Redherring32/Xbox-Portable/README.md

# Xbox-Portable
Fully portable original (2001) Xbox handheld using real hardware

## License:

Licensed under
the TAPR Open Hardware License (www.tapr.org/OHL)

©Redherring32 2023-2024
