Redherring32/Xbox-Portable/PSU/BOM.csv

Query | Qty | Manufacturer | MPN | Octopart URL | Part Description | Description | Schematic Reference | Internal Part Number | Lifecycle | Lead Time | RoHS | Total Qty (@ Batch Size: 1) | SKU | SKU | SKU | SKU | SKU | Packaging | Packaging | Packaging | Packaging | Packaging | Unit Price (@ Batch Size: 1) | Unit Price (@ Batch Size: 1) | Unit Price (@ Batch Size: 1) | Unit Price (@ Batch Size: 1) | Unit Price (@ Batch Size: 1) | In Stock | In Stock | In Stock | In Stock | In Stock | MOQ | MOQ | MOQ | MOQ | MOQ | URL | URL | URL | URL | URL | Distributor [Lowest Price (Selected)] | SKU [Lowest Price (Selected)] | Packaging [Lowest Price (Selected)] | Unit Price (@ Batch Size: 1) [Lowest Price (Selected)] | Line Total [Lowest Price (Selected)] | Batch Total [Lowest Price (Selected)] | In Stock [Lowest Price (Selected)] | MOQ [Lowest Price (Selected)] | URL [Lowest Price (Selected)] | Notes
 |  |  |  |  |  |  |  |  |  |  |  |  | Digi-Key | Mouser | Newark | Onlinecomponents.com | RS Components | Digi-Key | Mouser | Newark | Onlinecomponents.com | RS Components | Digi-Key | Mouser | Newark | Onlinecomponents.com | RS Components | Digi-Key | Mouser | Newark | Onlinecomponents.com | RS Components | Digi-Key | Mouser | Newark | Onlinecomponents.com | RS Components | Digi-Key | Mouser | Newark | Onlinecomponents.com | RS Components
KGM05AR71C104JN | 5 | KYOCERA AVX | KGM05AR71C104JN | https://octopart.com/kgm05ar71c104jn-kyocera+avx-137404918 | Cap Cer 0.1UF 16V X7R 0402 | 0.1uF | C1, C24, C40, C56, C72 |  |  |  |  | 5
GRM32EC81A476KE19L | 15 | Murata | GRM32EC81A476KE19L | https://octopart.com/grm32ec81a476ke19l-murata-18041261 | Multilayer Ceramic Capacitor, 47 uF, 10 V, ± 10%, X6S, 1210 [3225 Metric] | 47uF | C2, C3, C4, C25, C26, C27, C41, C42, C43, C57, C58, C59, C73, C74, C75 |  | Production (Last Updated: 1 month ago) | 19w | Compliant | 15 | 490-8354-1-ND | 81-GRM32EC81A476KE9L | 43T5299 |  |  | Cut Tape | Tape & Reel | Cut Tape |  |  | 0.289 | 0.463 | 0.482 |  |  | 43324 | 3526 | 709 |  |  | 1 | 1 | 1 |  |  | https://octopart.com/opatz8j6/a1 | https://octopart.com/opatz8j6/a1 | https://octopart.com/opatz8j6/a1 |  |  | DigiKey | 490-8354-1-ND | Cut Tape | 0.289 | 4.335 | 4.335 | 43324 | 1 | https://octopart.com/opatz8j6/a1
CL10A226MO7JZNC | 28 | Samsung | CL10A226MO7JZNC | https://octopart.com/cl10a226mo7jznc-samsung-82337114 | Multilayer Ceramic Capacitor, 22 uF, 16 V, ± 20%, X5R, 0603 [1608 Metric] | 47uF | C5, C11, C12, C16, C28, C29, C30, C31, C44, C45, C46, C47, C60, C61, C62, C63, C76, C77, C78, C79, C8, C20, C36, C52, C68, C82, C83, C84 |  | Production (Last Updated: 4 years ago) | 22w | Non-Compliant | 28 | 1276-7076-1-ND | 187-CL10A226MO7JZNC |  |  |  | Cut Tape | Tape & Reel |  |  |  | 0.398 | 0.317 |  |  |  | 1140870 | 334159 |  |  |  | 1 | 1 |  |  |  | https://octopart.com/opatz8j6/a1 | https://octopart.com/opatz8j6/a1 |  |  |  | Mouser | 187-CL10A226MO7JZNC | Tape & Reel | 0.317 | 8.876 | 8.876 | 334159 | 1 | https://octopart.com/opatz8j6/a1
CL05A105KO5NNNC | 5 | Samsung | CL05A105KO5NNNC | https://octopart.com/cl05a105ko5nnnc-samsung-9301309 | Multilayer Ceramic Capacitor, 1 uF, 16 V, ± 10%, X5R, 0402 [1005 Metric] | 1uF | C6, C22, C38, C54, C70 |  | Production (Last Updated: 4 years ago) | 22w | Compliant | 5 | 1276-1067-1-ND | 187-CL05A105KO5NNNC | 82AC9181 |  |  | Cut Tape | Tape & Reel | Cut Tape |  |  | 0.1 | 0.1 | 0.104 |  |  | 3677274 | 281660 | 14503 |  |  | 1 | 1 | 1 |  |  | https://octopart.com/opatz8j6/a1 | https://octopart.com/opatz8j6/a1 | https://octopart.com/opatz8j6/a1 |  |  | DigiKey | 1276-1067-1-ND | Cut Tape | 0.1 | 0.5 | 0.5 | 3677274 | 1 | https://octopart.com/opatz8j6/a1
CL32A226KPJNNNE | 15 | Samsung | CL32A226KPJNNNE | https://octopart.com/cl32a226kpjnnne-samsung-20879308 | Cap Ceramic 22uF 10V X5R 10% SMD 1210 85°C Embossed T/R | 22uF | C9, C14, C15, C17, C18, C19, C33, C34, C35, C49, C50, C51, C65, C66, C67 |  | Production (Last Updated: 4 years ago) | 22w | Compliant | 15 | 1276-3372-1-ND | 187-CL32A226KPJNNNE |  |  |  | Cut Tape | Tape & Reel |  |  |  | 0.198 | 0.147 |  |  |  | 324463 | 119352 |  |  |  | 1 | 1 |  |  |  | https://octopart.com/opatz8j6/a1 | https://octopart.com/opatz8j6/a1 |  |  |  | Mouser | 187-CL32A226KPJNNNE | Tape & Reel | 0.147 | 2.205 | 2.205 | 119352 | 1 | https://octopart.com/opatz8j6/a1
CL10A475KP8NNNC | 6 | Samsung | CL10A475KP8NNNC | https://octopart.com/cl10a475kp8nnnc-samsung-9301844 | Multilayer Ceramic Capacitor, 4.7 uF, 10 V, ± 10%, X5R, 0603 [1608 Metric] | 4.7uF | C10, C23, C39, C55, C71, C88 |  | Production (Last Updated: 4 years ago) | 22w | Compliant | 6 | 1276-1044-1-ND | 187-CL10A475KP8NNNC | 82AC9299 |  |  | Cut Tape | Tape & Reel | Cut Tape |  |  | 0.1 | 0.1 | 0.104 |  |  | 7501831 | 1131283 | 5722 |  |  | 1 | 1 | 1 |  |  | https://octopart.com/opatz8j6/a1 | https://octopart.com/opatz8j6/a1 | https://octopart.com/opatz8j6/a1 |  |  | DigiKey | 1276-1044-1-ND | Cut Tape | 0.1 | 0.6000000000000001 | 0.6000000000000001 | 7501831 | 1 | https://octopart.com/opatz8j6/a1
CL10B104KB8NNNL | 5 | Samsung | CL10B104KB8NNNL | https://octopart.com/cl10b104kb8nnnl-samsung-21395620 | Multilayer Ceramic Capacitor, 0.1 uF, 50 V, ± 10%, X7R, 0603 [1608 Metric] | 0.1uF | C13, C32, C48, C64, C80 |  | Production (Last Updated: 4 years ago) | 22w | Compliant | 5 | 1276-CL10B104KB8NNNLCT-ND | 187-CL10B104KB8NNNL |  |  |  | Cut Tape | Tape & Reel |  |  |  | 0.1 | 0.1 |  |  |  | 2569681 | 390005 |  |  |  | 1 | 1 |  |  |  | https://octopart.com/opatz8j6/a1 | https://octopart.com/opatz8j6/a1 |  |  |  | DigiKey | 1276-CL10B104KB8NNNLCT-ND | Cut Tape | 0.1 | 0.5 | 0.5 | 2569681 | 1 | https://octopart.com/opatz8j6/a1
GRM188R61E106MA73J | 4 | Murata | GRM188R61E106MA73J | https://octopart.com/grm188r61e106ma73j-murata-46693355 | Multilayer Ceramic Capacitor, 10 uF, 25 V, ± 20%, X5R, 0603 [1608 Metric] | 10uF | C81, C86, C89, C90 |  | Production (Last Updated: 1 month ago) | 19w | Compliant | 4 | 490-12737-1-ND | 81-GRM188R61E106MA3J |  |  |  | Cut Tape | Tape & Reel |  |  |  | 0.29 | 0.28 |  |  |  | 93315 | 61644 |  |  |  | 1 | 1 |  |  |  | https://octopart.com/opatz8j6/a1 | https://octopart.com/opatz8j6/a1 |  |  |  | Mouser | 81-GRM188R61E106MA3J | Tape & Reel | 0.28 | 1.12 | 1.12 | 61644 | 1 | https://octopart.com/opatz8j6/a1
C1608X7R1E105K080AB | 1 | TDK | C1608X7R1E105K080AB | https://octopart.com/c1608x7r1e105k080ab-tdk-25947659 | Multilayer Ceramic Capacitor, 1 uF, 25 V, ± 10%, X7R, 0603 [1608 Metric] | 1uF | C85 |  | Production (Last Updated: 1 year ago) | 24w | Compliant | 1 | 445-5956-1-ND | 810-C1608X7R1E105K | 04X3256 |  |  | Cut Tape | Tape & Reel |  |  |  | 0.19 | 0.19 | 0.223 |  |  | 212176 | 5918 | 2 |  |  | 1 | 1 | 1 |  |  | https://octopart.com/opatz8j6/a1 | https://octopart.com/opatz8j6/a1 | https://octopart.com/opatz8j6/a1 |  |  | DigiKey | 445-5956-1-ND | Cut Tape | 0.19 | 0.19 | 0.19 | 212176 | 1 | https://octopart.com/opatz8j6/a1
CL10B473KO8NNNC | 1 | Samsung | CL10B473KO8NNNC | https://octopart.com/cl10b473ko8nnnc-samsung-9291615 | Cap Ceramic 0.047uF 16V X7R 10% SMD 0603 125°C Paper T/R | 47nF | C87 |  | Production (Last Updated: 4 years ago) | 22w | Compliant | 1 | 1276-2079-1-ND | 187-CL10B473KO8NNNC |  |  |  | Cut Tape | Tape & Reel |  |  |  | 0.1 | 0.1 |  |  |  | 1168873 | 7121 |  |  |  | 1 | 1 |  |  |  | https://octopart.com/opatz8j6/a1 | https://octopart.com/opatz8j6/a1 |  |  |  | DigiKey | 1276-2079-1-ND | Cut Tape | 0.1 | 0.1 | 0.1 | 1168873 | 1 | https://octopart.com/opatz8j6/a1
SIC437DED-T1-GE3 | 5 | Vishay | SIC437DED-T1-GE3 | https://octopart.com/sic437ded-t1-ge3-vishay-91387604 | 3-28V input, 12A microBUCK with Internal compensation, External Bias, 50 µA quie | SIC437BED-T1-GE3 | IC1, IC2, IC3, IC4, IC5 |  |  | 14w | Compliant | 5 | SIC437DED-T1-GE3CT-ND | 78-SIC437DED-T1-GE3 |  |  |  | Cut Tape | Tape & Reel |  |  |  | 1.93 | 1.93 |  |  |  | 7480 | 1737 |  |  |  | 1 | 1 |  |  |  | https://octopart.com/opatz8j6/a1 | https://octopart.com/opatz8j6/a1 |  |  |  | Mouser | 78-SIC437DED-T1-GE3 | Tape & Reel | 1.93 | 9.65 | 9.65 | 1737 | 1 | https://octopart.com/opatz8j6/a1
SRP7050TA-1R5M | 6 | Bourns | SRP7050TA-1R5M | https://octopart.com/srp7050ta-1r5m-bourns-64724107 | Inductor Power Shielded Wirewound 1.5uH 20% 100KHz 15Q-Factor Carbonyl Powder 12A 0.009Ohm DCR Automotive T/R | 1.5uH | L1, L2, L3, L4, L5, L6 |  |  | 20w | Compliant | 6 | SRP7050TA-1R5MCT-ND | 652-SRP7050TA-1R5M |  | SRP7050TA-1R5M |  | Cut Tape | Tape & Reel |  | Bulk |  | 1.32 | 1.12 |  |  |  | 1293 | 3054 |  | 1600 |  | 1 | 1 |  | 800 |  | https://octopart.com/opatz8j6/a1 | https://octopart.com/opatz8j6/a1 |  | https://octopart.com/opatz8j6/a1 |  | Mouser | 652-SRP7050TA-1R5M | Tape & Reel | 1.12 | 6.720000000000001 | 6.720000000000001 | 3054 | 1 | https://octopart.com/opatz8j6/a1
ERJ-2GEJ2R2X | 5 | Panasonic | ERJ-2GEJ2R2X | https://octopart.com/erj-2gej2r2x-panasonic-55420722 | SMD Chip Resistor, 2.2 Ohm, ± 5%, 100 mW, 0402 [1005 Metric], Thick Film, General Purpose | 2.2R | R1, R13, R20, R27, R34 |  | Production (Last Updated: 3 years ago) | 21w | Compliant | 5 | P2.2JCT-ND | 667-ERJ-2GEJ2R2X | 85Y7932 | ERJ-2GEJ2R2X |  | Cut Tape | Tape & Reel | Cut Tape | Bulk |  | 0.1 | 0.1 |  |  |  | 371354 | 45493 | 34870 | 93050 |  | 1 | 1 | 10 | 10000 |  | https://octopart.com/opatz8j6/a1 | https://octopart.com/opatz8j6/a1 | https://octopart.com/opatz8j6/a1 | https://octopart.com/opatz8j6/a1 |  | DigiKey | P2.2JCT-ND | Cut Tape | 0.1 | 0.5 | 0.5 | 371354 | 1 | https://octopart.com/opatz8j6/a1
ERJ-2RKF1003X | 6 | Panasonic | ERJ-2RKF1003X | https://octopart.com/erj-2rkf1003x-panasonic-55403629 | Res Thick Film 0402 100K Ohm 1% 1/10W ±100ppm/°C Molded SMD Punched Carrier T/R | 100K | R2, R9, R16, R23, R30, R41 |  | Production (Last Updated: 3 years ago) | 21w | Compliant | 6 | P100KLCT-ND | 667-ERJ-2RKF1003X | 64R5249 | ERJ-2RKF1003X |  | Cut Tape | Tape & Reel | Cut Tape | Bulk |  | 0.1 | 0.1 | 0.099 |  |  | 3992212 | 8552150 | 32655 | 220000 |  | 1 | 1 | 1 | 10000 |  | https://octopart.com/opatz8j6/a1 | https://octopart.com/opatz8j6/a1 | https://octopart.com/opatz8j6/a1 | https://octopart.com/opatz8j6/a1 |  | Newark | 64R5249 | Cut Tape | 0.099 | 0.5940000000000001 | 0.5940000000000001 | 32655 | 1 | https://octopart.com/opatz8j6/a1
ERJ-2RKF4993X | 5 | Panasonic | ERJ-2RKF4993X | https://octopart.com/erj-2rkf4993x-panasonic-39821441 | Res Thick Film 0402 499K Ohm 1% 0.1W ±100ppm/°C Molded SMD Punched Carrier T/R | 499K | R3, R10, R17, R24, R31 |  | Production (Last Updated: 3 years ago) | 21w | Compliant | 5 | P499KLCT-ND | 667-ERJ-2RKF4993X | 73T6531 | ERJ-2RKF4993X |  | Cut Tape | Tape & Reel | Cut Tape | Bulk |  | 0.1 | 0.1 | 0.006 |  |  | 977444 | 124145 | 54209 | 384530 |  | 1 | 1 | 1 | 10000 |  | https://octopart.com/opatz8j6/a1 | https://octopart.com/opatz8j6/a1 | https://octopart.com/opatz8j6/a1 | https://octopart.com/opatz8j6/a1 |  | Newark | 73T6531 | Cut Tape | 0.006 | 0.03 | 0.03 | 54209 | 1 | https://octopart.com/opatz8j6/a1
ERJ-2RKF1302X | 1 | Panasonic | ERJ-2RKF1302X | https://octopart.com/erj-2rkf1302x-panasonic-55420894 | Res Thick Film 0402 13K Ohm 1% 0.1W(1/10W) ±100ppm/°C Pad SMD T/R Automotive AEC-Q200 | 13K | R4 |  | Production (Last Updated: 3 years ago) | 21w | Compliant | 1 | P13.0KLCT-ND | 667-ERJ-2RKF1302X | 53W4207 | ERJ-2RKF1302X |  | Cut Tape | Tape & Reel | Cut Tape | Bulk |  | 0.1 | 0.1 | 0.002 |  |  | 236103 | 74210 | 69501 | 250228 |  | 1 | 1 | 1 | 10000 |  | https://octopart.com/opatz8j6/a1 | https://octopart.com/opatz8j6/a1 | https://octopart.com/opatz8j6/a1 | https://octopart.com/opatz8j6/a1 |  | Newark | 53W4207 | Cut Tape | 0.002 | 0.002 | 0.002 | 69501 | 1 | https://octopart.com/opatz8j6/a1
ERJ-2RKF1002X | 15 | Panasonic | ERJ-2RKF1002X | https://octopart.com/erj-2rkf1002x-panasonic-55411477 | Res Thick Film 0402 10K Ohm 1% 1/10W ±100ppm/°C Molded SMD Punched Carrier T/R | 10K | R5, R6, R7, R8, R11, R12, R15, R18, R19, R22, R25, R26, R29, R32, R33 |  | Production (Last Updated: 3 years ago) | 21w | Compliant | 15 | P10.0KLCT-ND | 667-ERJ-2RKF1002X | 85Y8053 | ERJ-2RKF1002X |  | Cut Tape | Tape & Reel | Cut Tape | Bulk |  | 0.024 | 0.016 | 0.016 |  |  | 5301483 | 4525988 | 308665 | 3560500 |  | 1 | 1 | 10 | 10000 |  | https://octopart.com/opatz8j6/a1 | https://octopart.com/opatz8j6/a1 | https://octopart.com/opatz8j6/a1 | https://octopart.com/opatz8j6/a1 |  | Mouser | 667-ERJ-2RKF1002X | Tape & Reel | 0.016 | 0.24 | 0.24 | 4525988 | 1 | https://octopart.com/opatz8j6/a1
ERJ-U02F1502X | 1 | Panasonic | ERJ-U02F1502X | https://octopart.com/erj-u02f1502x-panasonic-26326557 | Res Thick Film 0402 15K Ohm 1% 1/10W ±200ppm/°C Molded SMD SMD Punched Carrier T/R | 15K | R14 |  |  | 16w | Compliant | 1 | 10-ERJ-U02F1502XCT-ND | 667-ERJ-U02F1502X |  | ERJ-U02F1502X |  | Cut Tape | Tape & Reel |  | Bulk |  | 0.1 | 0.11 |  |  |  | 147080 | 50911 |  | 0 |  | 1 | 1 |  | 10000 |  | https://octopart.com/opatz8j6/a1 | https://octopart.com/opatz8j6/a1 |  | https://octopart.com/opatz8j6/a1 |  | DigiKey | 10-ERJ-U02F1502XCT-ND | Cut Tape | 0.1 | 0.1 | 0.1 | 147080 | 1 | https://octopart.com/opatz8j6/a1
ERJ-2RKF2002X | 1 | Panasonic | ERJ-2RKF2002X | https://octopart.com/erj-2rkf2002x-panasonic-55477596 | Res Thick Film 0402 20K Ohm 1% 1/10W ±100ppm/°C Molded SMD Punched Carrier T/R | 20K | R21 |  | Production (Last Updated: 3 years ago) | 21w | Compliant | 1 | P20.0KLCT-ND | 667-ERJ-2RKF2002X | 73T6487 | ERJ-2RKF2002X |  | Cut Tape | Tape & Reel | Cut Tape | Bulk |  | 0.1 | 0.1 | 0.098 |  |  | 670325 | 1271760 | 6389 | 1208000 |  | 1 | 1 | 1 | 10000 |  | https://octopart.com/opatz8j6/a1 | https://octopart.com/opatz8j6/a1 | https://octopart.com/opatz8j6/a1 | https://octopart.com/opatz8j6/a1 |  | Newark | 73T6487 | Cut Tape | 0.098 | 0.098 | 0.098 | 6389 | 1 | https://octopart.com/opatz8j6/a1
ERJ-2RKF3402X | 1 | Panasonic | ERJ-2RKF3402X | https://octopart.com/erj-2rkf3402x-panasonic-55421118 | Res Thick Film 0402 34K Ohm 1% 0.1W(1/10W) +/-100ppm/C Molded SMD Automotive Punched T/R | 34K | R28 |  | Production (Last Updated: 3 years ago) | 21w | Compliant | 1 | P34.0KLCT-ND | 667-ERJ-2RKF3402X |  | ERJ-2RKF3402X |  | Cut Tape | Tape & Reel |  | Bulk |  | 0.1 | 0.1 |  |  |  | 81749 | 36372 |  | 199949 |  | 1 | 1 |  | 10000 |  | https://octopart.com/opatz8j6/a1 | https://octopart.com/opatz8j6/a1 |  | https://octopart.com/opatz8j6/a1 |  | DigiKey | P34.0KLCT-ND | Cut Tape | 0.1 | 0.1 | 0.1 | 81749 | 1 | https://octopart.com/opatz8j6/a1
ERJ-2RKF4532X | 1 | Panasonic | ERJ-2RKF4532X | https://octopart.com/erj-2rkf4532x-panasonic-55403638 | SMD Chip Resistor, 45.3 kOhm, ± 1%, 100 mW, 0402 [1005 Metric], Thick Film, Precision | 45K | R35 |  | Production (Last Updated: 3 years ago) | 21w | Compliant | 1 | P45.3KLCT-ND | 667-ERJ-2RKF4532X | 53W4382 | ERJ-2RKF4532X |  | Cut Tape | Tape & Reel | Cut Tape | Bulk |  | 0.1 | 0.1 | 0.002 |  |  | 193887 | 138364 | 44040 | 139533 |  | 1 | 1 | 1 | 10000 |  | https://octopart.com/opatz8j6/a1 | https://octopart.com/opatz8j6/a1 | https://octopart.com/opatz8j6/a1 | https://octopart.com/opatz8j6/a1 |  | Newark | 53W4382 | Cut Tape | 0.002 | 0.002 | 0.002 | 44040 | 1 | https://octopart.com/opatz8j6/a1
RC0805FR-07200RL | 1 | Yageo | RC0805FR-07200RL | https://octopart.com/rc0805fr-07200rl-yageo-1212698 | SMD Chip Resistor, 200 Ohm, ± 1%, 125 mW, 0805 [2012 Metric], Thick Film, General Purpose | 200R | R36 |  |  | 18w | Compliant | 1 | 311-200CRCT-ND | 603-RC0805FR-07200RL | 82AH8300 |  |  | Cut Tape | Tape & Reel | Cut Tape |  |  | 0.1 | 0.1 |  |  |  | 451290 | 739854 | 246612 |  |  | 1 | 1 | 10 |  |  | https://octopart.com/opatz8j6/a1 | https://octopart.com/opatz8j6/a1 | https://octopart.com/opatz8j6/a1 |  |  | Mouser | 603-RC0805FR-07200RL | Tape & Reel | 0.1 | 0.1 | 0.1 | 739854 | 1 | https://octopart.com/opatz8j6/a1
MAX16054 | 1 | Amphenol | MAX16054 | https://octopart.com/max16054-amphenol-27074272 | max16054 on/off controller with debounce and ±15kv esd protection industrys smallest pushbutton on/off controller | MAX16054 | U1 |  |  |  |  | 1
TPS61235PRWLT | 1 | Texas Instruments | TPS61235PRWLT | https://octopart.com/tps61235prwlt-texas+instruments-75117734 | Conv DC-DC 2.3V to 4.5V Synchronous Step Up Single-Out 5.1V 8A 9-Pin VQFN-HR EP T/R | TPS61235PRWLT | U2 |  | Production (Last Updated: 1 day ago) | 6w | Compliant | 1 | 296-44628-1-ND | 595-TPS61235PRWLT |  |  |  | Cut Tape | Tape & Reel |  |  |  | 1.9 | 2.7 |  |  |  | 10143 | 1257 |  |  |  | 1 | 1 |  |  |  | https://octopart.com/opatz8j6/a1 | https://octopart.com/opatz8j6/a1 |  |  |  | DigiKey | 296-44628-1-ND | Cut Tape | 1.9 | 1.9 | 1.9 | 10143 | 1 | https://octopart.com/opatz8j6/a1
