Redherring32/Xbox-Portable/USB-C PCB/3D/USB4110GFA.step

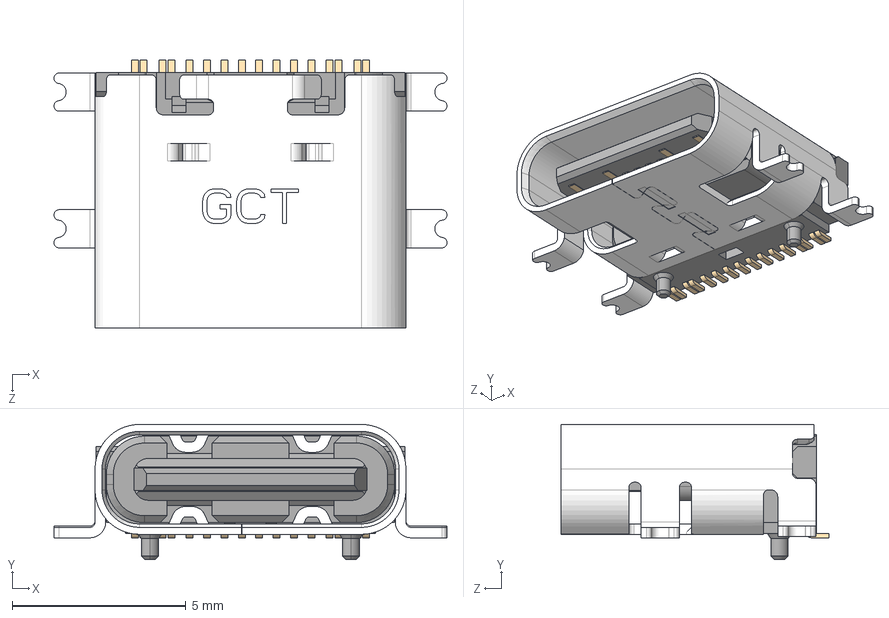
[picture p1: CAD file, 2025-05-27]
USB-C PCB/3D/USB4110GFA.step
11.3 x 3.89 x 7.70 mm
