Redherring32/Xbox-Portable/FlexPCBs/USB-Termination/USB-Termination.kicad_pcb

## KiCad design FlexPCBs/USB-Termination/USB-Termination.kicad_pcb (2025-05-27)

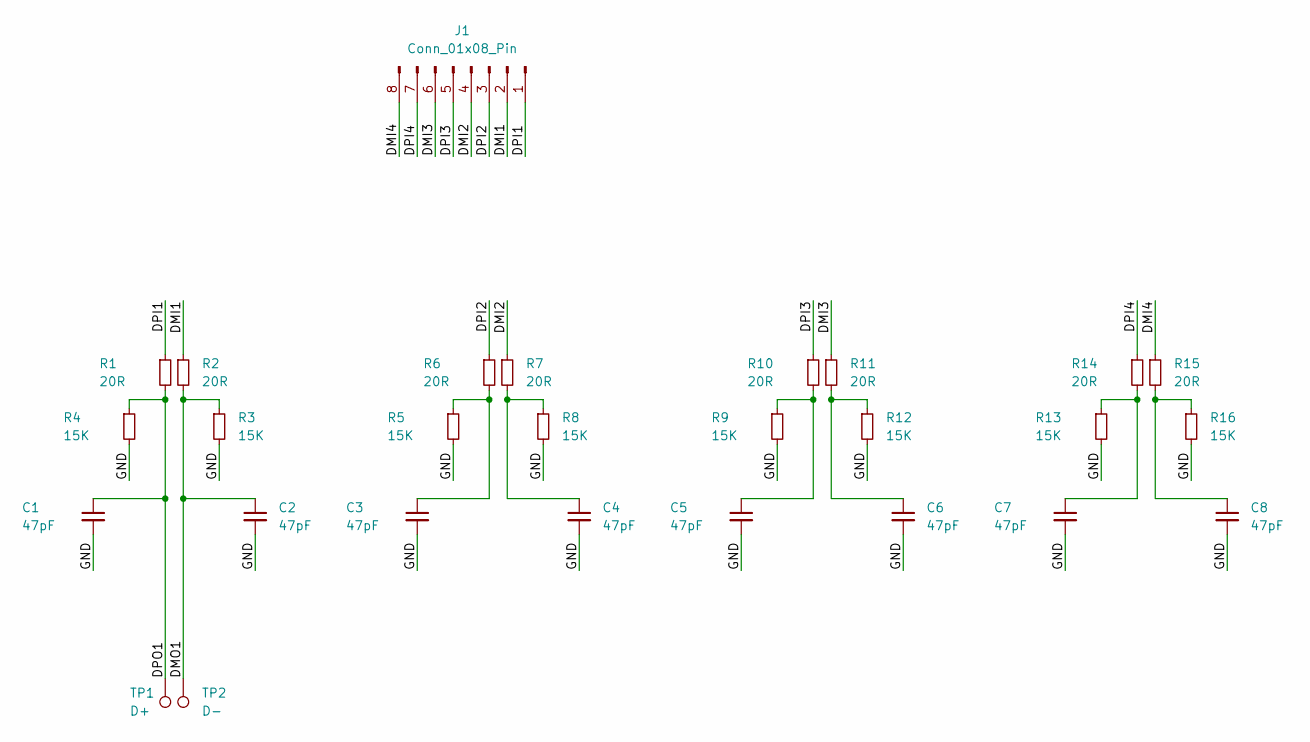
[picture p2: schematic USB-Termination.kicad_sch]

Parts:
C1, C2, C3, C4, C5, C6, C7, C8: 47pF; C_0201_0603Metric
J1: Conn_01x08_Pin; Vias
R1, R2, R6, R7, R10, R11, R14, R15: 20R; R_0201_0603Metric
R3, R4, R5, R8, R9, R12, R13, R16: 15K; R_0201_0603Metric
TP1: D+; TestPoint_Pad_D1.0mm
TP2: D-; TestPoint_Pad_D1.0mm

Connections:
/DMI1: J1.2, R2.1
/DMI2: J1.4, R7.1
/DMI3: J1.6, R11.1
/DMI4: J1.8, R15.1
/DMO1: C2.1, R2.2, R3.1, TP2.1
/DPI1: J1.1, R1.1
/DPI2: J1.3, R6.1
/DPI3: J1.5, R10.1
/DPI4: J1.7, R14.1
/DPO1: C1.1, R1.2, R4.1, TP1.1
/GND: C1.2, C2.2, C3.2, C4.2, C5.2, C6.2, C7.2, C8.2, R3.2, R4.2, R5.2, R8.2, R9.2, R12.2, R13.2, R16.2
unnamed: C3.1, R5.1, R6.2
unnamed: C4.1, R7.2, R8.1
unnamed: C5.1, R9.1, R10.2
unnamed: C6.1, R11.2, R12.1
unnamed: C7.1, R13.1, R14.2
unnamed: C8.1, R15.2, R16.1

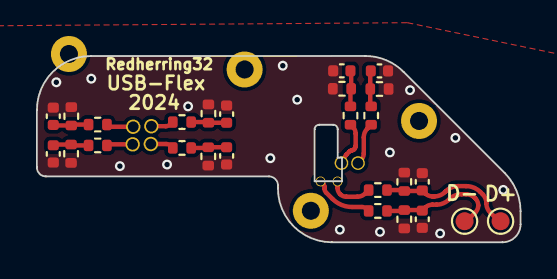
[picture p3: board USB-Termination.kicad_pcb from above]

Board: 2 copper layers, 26.9 x 10.3 mm, 27 parts (1 on the bottom side), 17 nets.
