Redherring32/Xbox-Portable/USB-C PCB/XboxUSB-C.kicad_pcb

## KiCad design USB-C PCB/XboxUSB-C.kicad_pcb (2025-05-27)

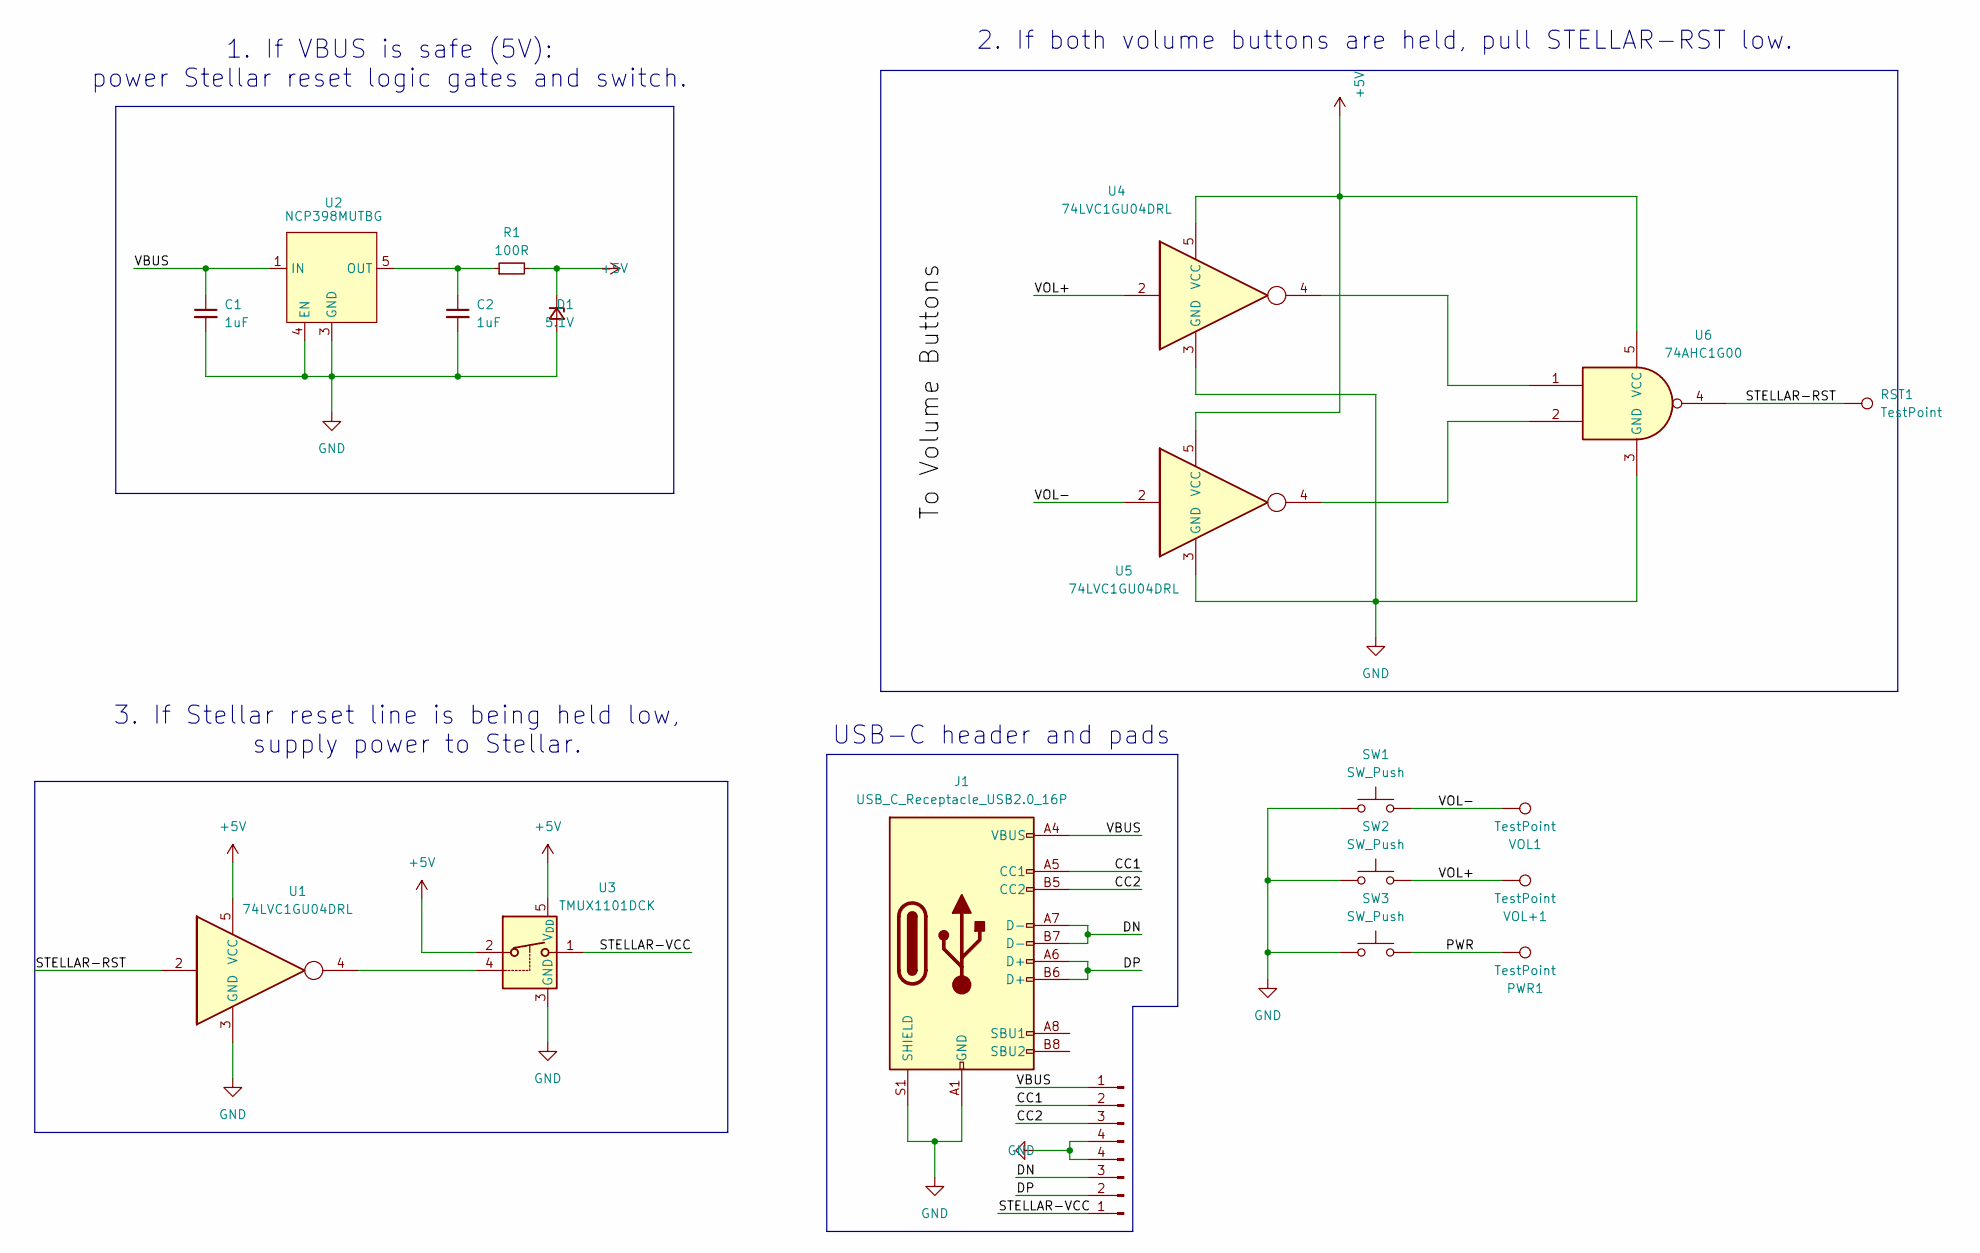
[picture p4: schematic XboxUSB-C.kicad_sch]

Parts:
C1, C2: 1uF; C_0805_2012Metric
D1: 5.1V; D_SOD-323_HandSoldering
J1: USB_C_Receptacle_USB2.0_16P; USB_C_Receptacle_GCT_USB4110
J2, J3: Conn_01x04_Pin; VBUS PADS
PWR1: TestPoint; TestPoint_Pad_D2.5mm
R1: 100R; R_0805_2012Metric
RST1: TestPoint; TestPoint_Pad_D2.5mm
SW1, SW2, SW3: SW_Push; SW_Tactile_SPST_Angled_PTS645Vx58-2LFS
U1, U4, U5: 74LVC1GU04DRL; SOT-553
U2: NCP398MUTBG; DFN-6-1EP_2x2mm_P0.65mm_EP1.01x1.7mm
U3: TMUX1101DCK; WSON-8-1EP_3x2.5mm_P0.5mm_EP1.2x1.5mm_PullBack
U6: 74AHC1G00; SOT-23-5
VOL1: TestPoint; TestPoint_Pad_D2.5mm
VOL+1: TestPoint; TestPoint_Pad_D2.5mm

Connections:
+5V: D1.1 (K), R1.2, U1.5 (VCC), U3.2, U3.5 (V_{DD}), U4.5 (VCC), U5.5 (VCC), U6.5 (VCC)
/CC1: J1.A5 (CC1), J3.2
/CC2: J1.B5 (CC2), J3.3
/DN: J1.A7 (D-), J1.B7 (D-), J2.3
/DP: J1.A6 (D+), J1.B6 (D+), J2.2
/PWR: PWR1.1, SW3.2
/STELLAR-RST: RST1.1, U1.2, U6.4
/STELLAR-VCC: J2.1, U3.1
/VOL+: SW2.2, U4.2, VOL+1.1
/VOL-: SW1.2, U5.2, VOL1.1; also elsewhere on the board
GND: C1.2, C2.2, D1.2 (A), J1.A1 (GND), J1.A12 (GND), J1.B1 (GND), J1.B12 (GND), J1.S1 (SHIELD), J2.4, J3.4, SW1.1, SW2.1, SW3.1, U1.3 (GND), U2.3 (GND), U2.4 (EN), U2.7 (PAD), U3.3 (GND), U3.9 (GND), U4.3 (GND), U5.3 (GND), U6.3 (GND)
IN: C1.1, J1.A4 (VBUS), J1.A9 (VBUS), J1.B4 (VBUS), J1.B9 (VBUS), J3.1, U2.1 (IN), U2.2 (IN)
unnamed: C2.1, R1.1, U2.5 (OUT), U2.6 (OUT)
unnamed: U1.4, U3.4
unnamed: U4.4, U6.1
unnamed: U5.4, U6.2

Notes on the sheet:
1. If VBUS is safe (5V): power Stellar reset logic gates and switch.
USB-C header and pads
2. If both volume buttons are held, pull STELLAR-RST low.
3. If Stellar reset line is being held low, supply power to Stellar.

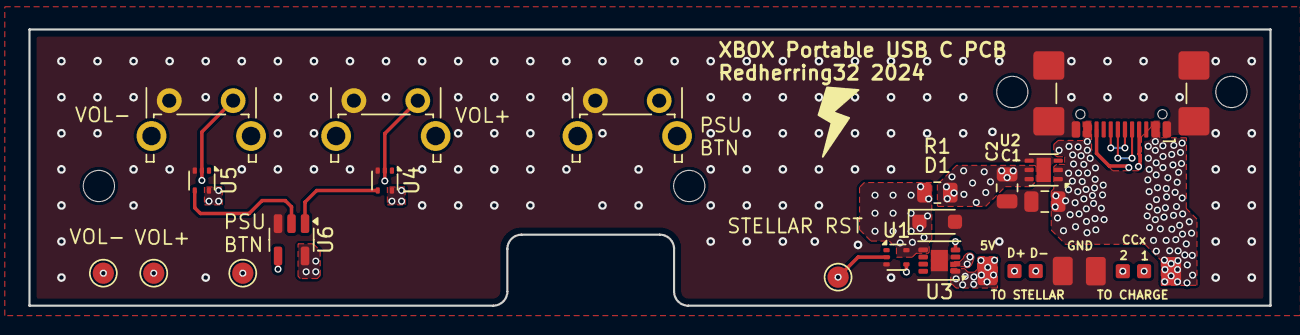
[picture p5: board XboxUSB-C.kicad_pcb from above]

Board: 4 copper layers, 87.4 x 19.4 mm, 24 parts (0 on the bottom side), 16 nets.

Other parts of the board:
MH1, MH2, MH2#2, MH2#3: MountingHole_2.2mm_M2
VOL-1: TestPoint; TestPoint_Pad_D1.5mm

Their connections:
/VOL-: VOL-1.1; also elsewhere on the board
