Redherring32/Xbox-Portable/Controller-PCBs/S Controller.kicad_pcb

## KiCad design Controller-PCBs/S Controller.kicad_pcb (2025-05-27)

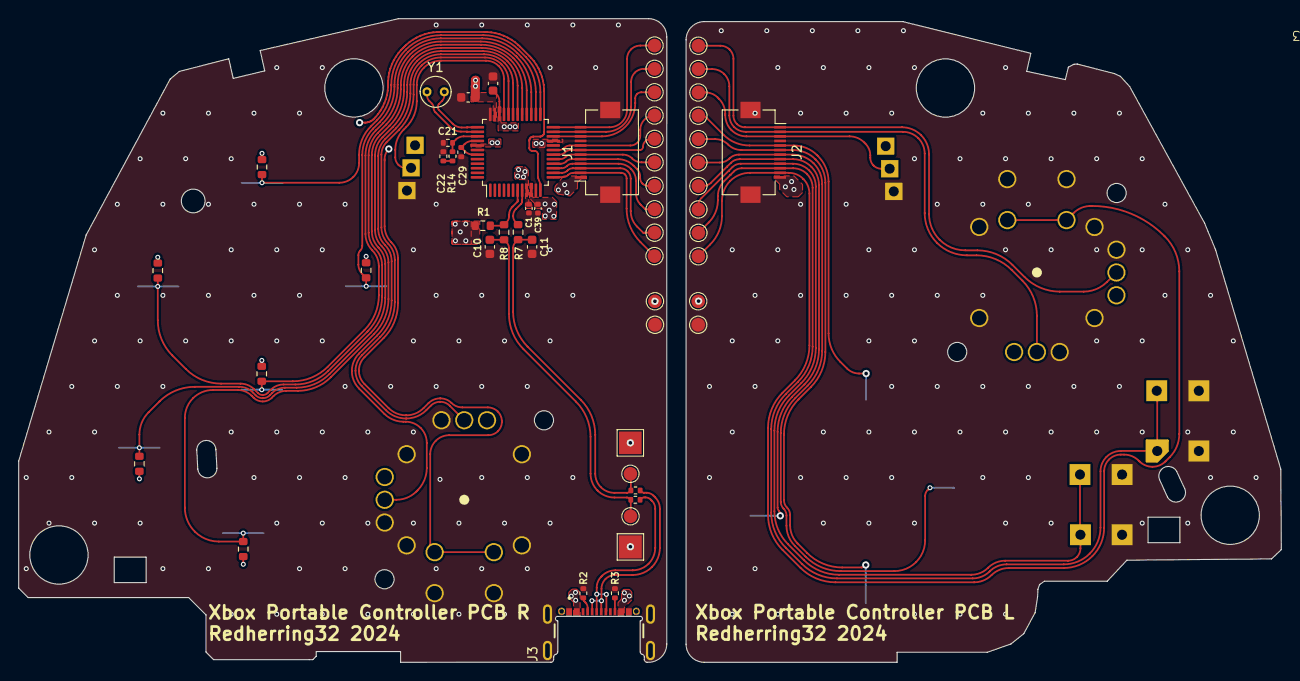
[picture p6: board S Controller.kicad_pcb from above]

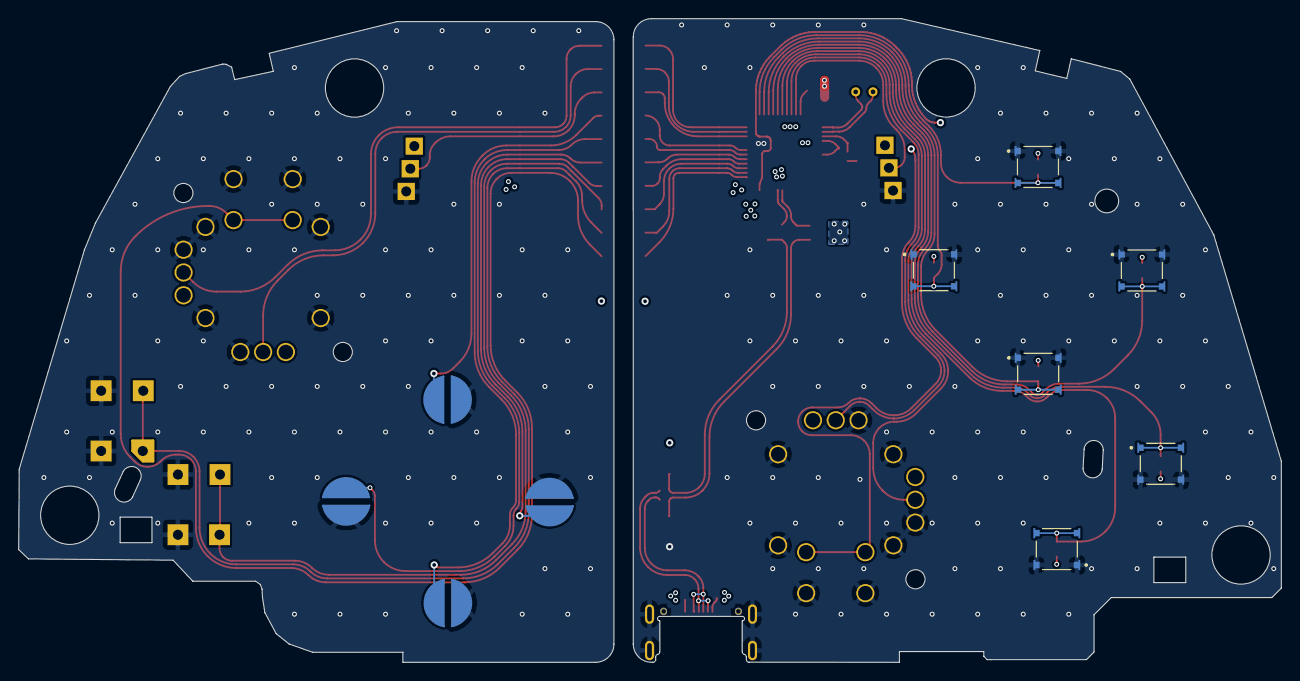
[picture p7: board S Controller.kicad_pcb from below]

Board: 4 copper layers, 138.6 x 70.7 mm, 70 parts (11 on the bottom side), 35 nets.

Parts:
C1: 2.2uF; C_0402_1005Metric
C10, C11: 50pF; C_0603_1608Metric
C21: 0.01uF; R_0402_1005Metric
C22: 0.1nF; R_0402_1005Metric
C29: 2.2uF; R_0402_1005Metric
C33: 0.1uF; C_0603_1608Metric
C36: 0.33uF; C_0603_1608Metric
C39: 0.01uF; C_0402_1005Metric
J1, J2: Conn_01x12_Pin; Hirose_FH12-12S-0.5SH_1x12-1MP_P0.50mm_Horizontal
J3: USB_C_Receptacle_USB2.0; GCT_USB4720-03-A_REVA
R1: 1.5K; R_0603_1608Metric
R2, R3: 5.1K; R_0402_1005Metric
R7, R8: 27R; R_0603_1608Metric
R14: 100R; R_0402_1005Metric
R17, R18, R24, R25, R31, R32: 4.7K; R_0603_1608Metric
RV1, RV2: R_Potentiometer_Small; TRIGGER-R
SW1, SW2, SW3, SW4, SW5, SW6: SW_Push; SW_TL3315NF100Q
SW7, SW8, SW9, SW10: SW_Push; DPADCONTACTS
SW11, SW12: SW_Push; StartBack
TP1, TP2, TP3, TP4, TP5, TP6, TP7, TP8, TP9, TP10, TP11, TP12, TP13, TP14, TP15, TP16, TP19, TP20, TP21, TP22, TP23, TP24, TP25, TP26, TP27, TP28: TestPoint; TestPoint_Pad_D1.5mm
TP17, TP18: TestPoint; TestPoint_Pad_2.5x2.5mm
U1: AT43USB353M-AC; LQFP-48_7x7mm_P0.5mm
U2, U3: RKJXV1224-Socket
Y1: 6MHz; Crystal_C38-LF_D3.0mm_L8.0mm_Vertical

Connections:
/Back: J1.3, J2.10, SW12.1, TP5.1, TP27.1, U1.14 (PA5)
/Black: R25.2, SW6.1, U1.29 (ADC4)
/ButtonA: R31.2, SW2.2, U1.27 (ADC6)
/ButtonB: R32.2, SW4.2, U1.28 (ADC5)
/ButtonX: R24.2, SW3.2, U1.26 (ADC7)
/ButtonY: R17.2, SW1.2, U1.25 (ADC8)
/CEXT1: C1.1, R1.2, U1.9 (CEXT1)
/CEXTA: C36.1, J1.1, J2.12, R17.1, R18.1, R24.1, R25.1, R31.1, R32.1, RV1.1, RV2.1, TP8.1, TP13.1, U1.35 (CEXTA), U2.5 (+), U2.8 (+), U3.5 (+), U3.8 (+)
/CPUSEL: C29.1, U1.40 (CEXT2), U1.43 (CPUSEL)
/D+: R1.1, R8.1, U1.7 (DP0)
/D-: R7.1, U1.8 (DM0)
/DpadD: J1.7, J2.6, SW8.1, TP4.1, TP23.1, U1.18 (PA1)
/DpadL: J1.6, J2.7, SW10.1, TP2.1, TP24.1, U1.17 (PA2)
/DpadR: J1.5, J2.8, SW9.1, TP3.1, TP25.1, U1.16 (PA3)
/DpadU: J1.8, J2.5, SW7.1, TP1.1, TP22.1, U1.19 (PA0)
/IN+: C10.1, J3.A6 (D+), J3.B6 (D+), R8.2, TP16.1
/IN-: C11.1, J3.A7 (D-), J3.B7 (D-), R7.2, TP15.1
/LFT: C21.1, R14.2, U1.39 (LFT)
/LStickX: J1.11, J2.2, TP9.1, TP20.1, U1.23 (ADC10), U3.7 (X)
/LStickY: J1.12, J2.1, TP10.1, TP19.1, U1.24 (ADC9), U3.4 (Y)
/RStickX: U1.32 (ADC1), U2.7 (X)
/RStickY: U1.31 (ADC2), U2.4 (Y)
/SClickL: J1.2, J2.11, TP11.1, TP28.1, U1.13 (PA6), U3.1
/SClickR: U1.12 (PA7), U2.1
/Start: J1.4, J2.9, SW11.1, TP6.1, TP26.1, U1.15 (PA4)
/TriggerL: J1.10, J2.3, RV2.2, TP12.1, TP21.1, U1.22 (ADC11)
/TriggerR: RV1.2, U1.33 (ADC0)
/VCC: C33.1, C39.1, J3.A4 (VBUS), J3.B4 (VBUS), TP17.1, U1.10 (VCC1), U1.34 (VCCA), U1.41 (VCC2)
/White: R18.2, SW5.2, U1.30 (ADC3)
/XTAL+: U1.37 (XTAL1), Y1.2
/XTAL-: U1.38 (XTAL2), Y1.1
GND: C1.2, C10.2, C11.2, C21.2, C22.1, C29.2, C33.2, C36.2, C39.2, J1.9, J1.MP, J2.4, J2.MP, J3.A12 (GND), J3.B12 (GND), J3.S1 (SHIELD), R2.2, R3.2, RV1.3, RV2.3, SW1.1, SW2.1, SW3.1, SW4.1, SW5.1, SW6.2, SW7.2, SW8.2, SW9.2, SW10.2, SW11.2, SW12.2, TP7.1, TP14.1, TP18.1, U1.11 (VSS1), U1.21 (TEST), U1.36 (VSSA), U1.42 (VSS2), U2.2, U2.3 (-), U2.6 (-), U3.2, U3.3 (-), U3.6 (-)
unnamed: C22.2, R14.1
unnamed: J3.A5 (CC1), R2.1
unnamed: J3.B5 (CC2), R3.1
