Redherring32/Xbox-Portable/PSU/Xbox-PMS.kicad_pcb

## KiCad design PSU/Xbox-PMS.kicad_pcb (2025-05-27)

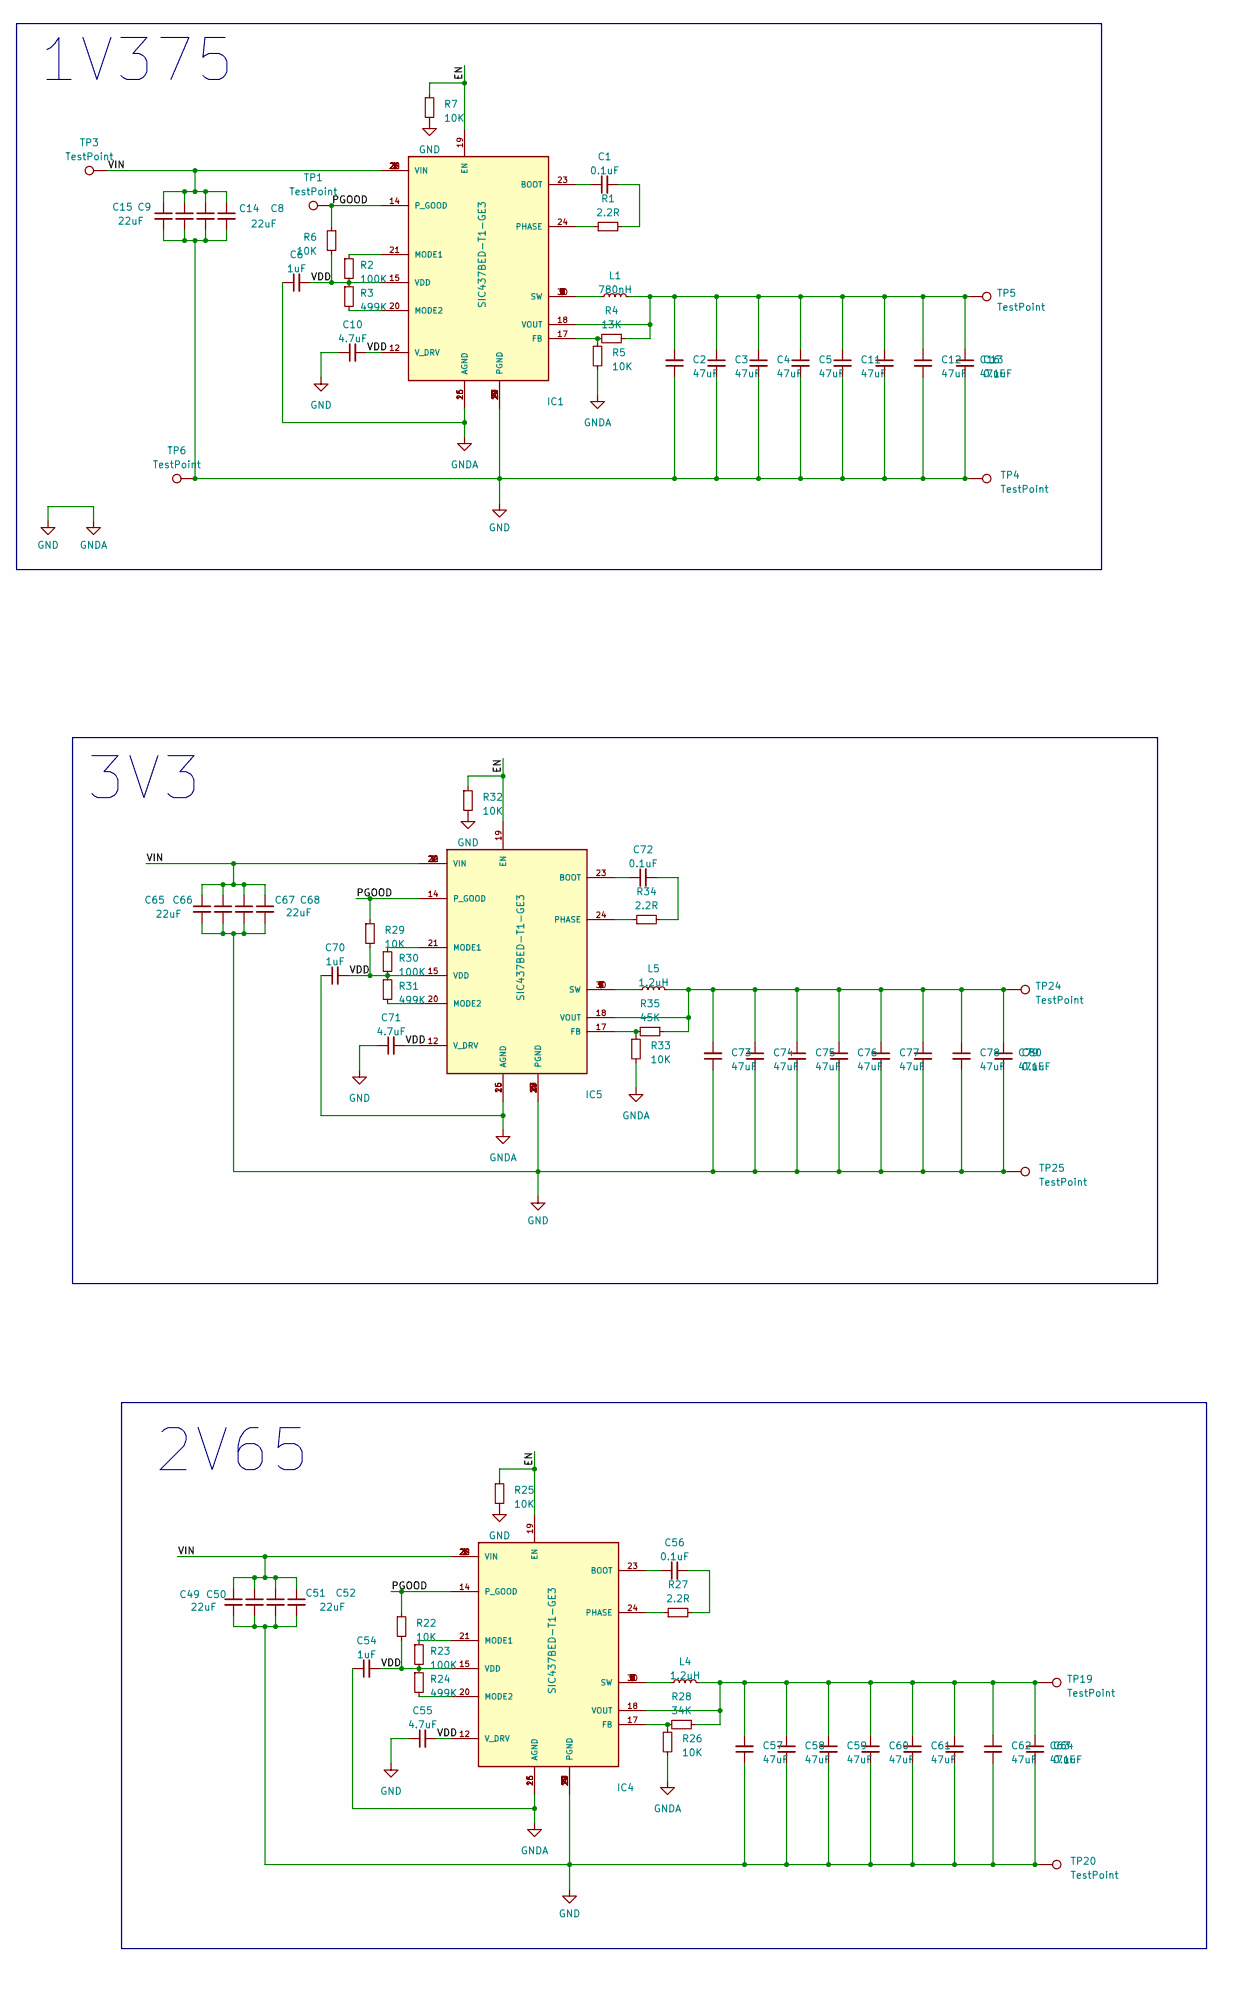
[picture p8: schematic Xbox-PMS.kicad_sch, part in row 1, column 1]

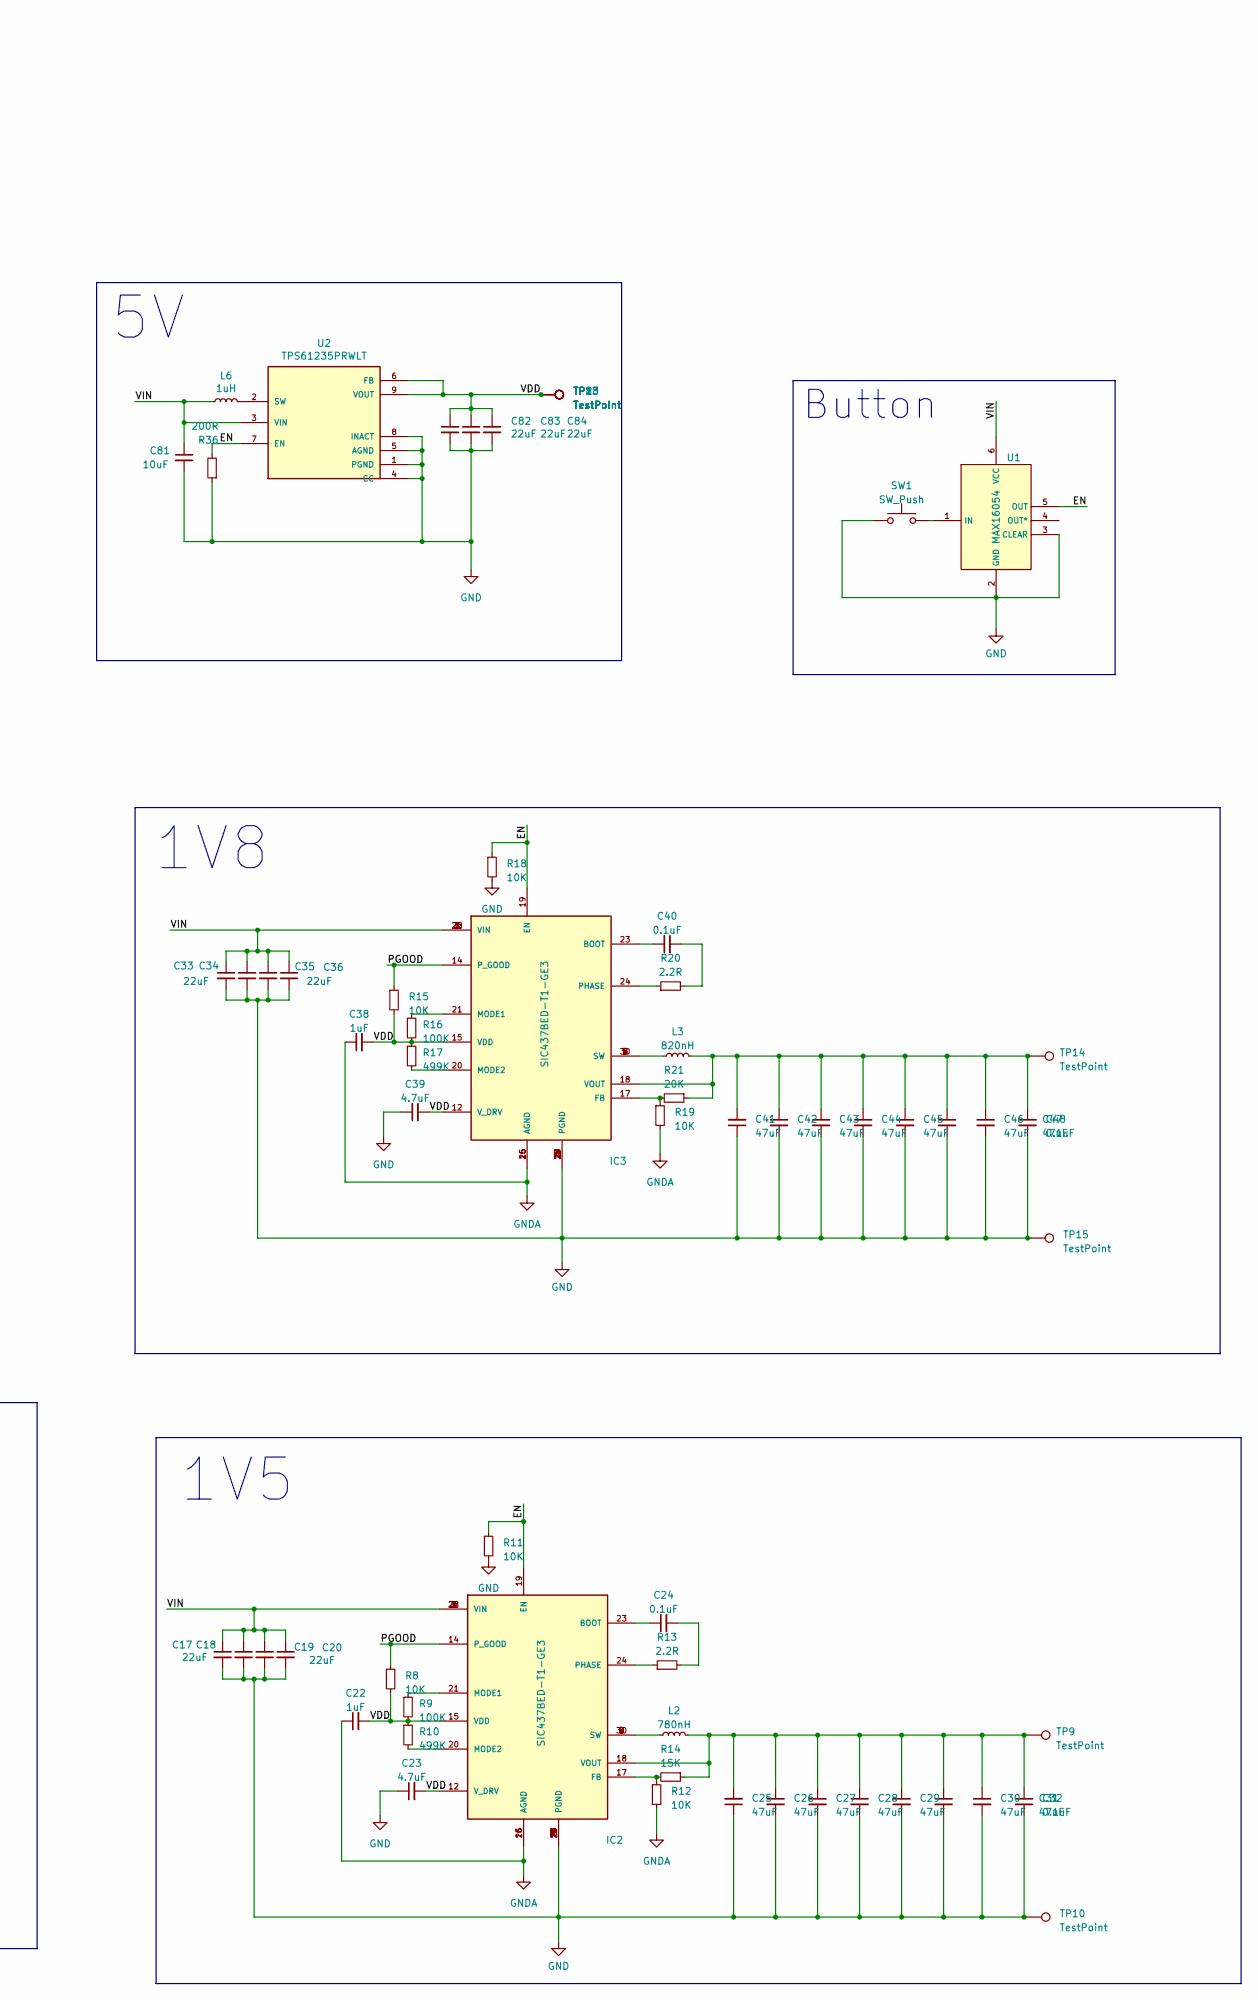
[picture p9: schematic Xbox-PMS.kicad_sch, part in row 1, column 2]

Parts:
C1, C24, C40, C56, C72: 0.1uF; C_0402_1005Metric
C2, C3, C4, C25, C26, C27, C41, C42, C43, C57, C58, C59, C73, C74, C75: 47uF; C_1210_3225Metric
C5, C11, C12, C16, C28, C29, C30, C31, C44, C45, C46, C47, C60, C61, C62, C63, C76, C77, C78, C79: 47uF; C_0603_1608Metric
C6, C22, C38, C54, C70: 1uF; C_0402_1005Metric
C8, C20, C36, C52, C68, C82, C83, C84: 22uF; C_0603_1608Metric
C9, C14, C15, C17, C18, C19, C33, C34, C35, C49, C50, C51, C65, C66, C67: 22uF; C_1210_3225Metric
C10, C23, C39, C55, C71: 4.7uF; C_0603_1608Metric
C13, C32, C48, C64, C80: 0.1uF; C_0603_1608Metric
C81: 10uF; C_0603_1608Metric
IC1, IC2, IC3, IC4, IC5: SIC437BED-T1-GE3; SIC437BEDT1GE3
L1, L2: 780nH; L_7.3x7.3_H4.5
L3: 820nH; L_7.3x7.3_H4.5
L4, L5: 1.2uH; L_7.3x7.3_H4.5
L6: 1uH; L_7.3x7.3_H4.5
R1, R13, R20, R27, R34: 2.2R; R_0402_1005Metric
R2, R9, R16, R23, R30: 100K; R_0402_1005Metric
R3, R10, R17, R24, R31: 499K; R_0402_1005Metric
R4: 13K; R_0402_1005Metric
R5, R6, R7, R8, R11, R12, R15, R18, R19, R22, R25, R26, R29, R32, R33: 10K; R_0402_1005Metric
R14: 15K; R_0402_1005Metric
R21: 20K; R_0402_1005Metric
R28: 34K; R_0402_1005Metric
R35: 45K; R_0402_1005Metric
R36: 200R; R_0805_2012Metric
SW1: SW_Push; Button
TP1, TP8, TP13, TP18, TP23: TestPoint; TestPoint_Pad_3.0x3.0mm
TP3, TP4, TP5, TP6, TP9, TP10, TP14, TP15, TP19, TP20, TP24, TP25: TestPoint; pad
U1: MAX16054; SOT-23-6
U2: TPS61235PRWLT; CONV_TPS61235PRWLT

Connections:
/EN: IC1.19 (EN), IC2.19 (EN), IC3.19 (EN), IC4.19 (EN), IC5.19 (EN), R7.1, R11.1, R18.1, R25.1, R32.1, R36.2, U1.5 (OUT), U2.7 (EN)
/PGOOD: IC1.14 (P_GOOD), IC2.14 (P_GOOD), IC3.14 (P_GOOD), IC4.14 (P_GOOD), IC5.14 (P_GOOD), R6.1, R8.1, R15.1, R22.1, R29.1, TP1.1
unnamed: C1.2, R1.2
unnamed: C24.2, R13.2
unnamed: C40.2, R20.2
unnamed: C56.2, R27.2
unnamed: C72.2, R34.2
unnamed: C1.1, IC1.23 (BOOT)
unnamed: IC1.17 (FB), R4.2, R5.1
unnamed: IC1.21 (MODE1), R2.1
unnamed: IC1.20 (MODE2), R3.2
unnamed: IC1.24 (PHASE), R1.1
unnamed: IC1.5 (SW), IC1.6 (SW), IC1.7 (SW), IC1.8 (SW), IC1.9 (SW), IC1.30 (SW), L1.1
unnamed: C2.2, C3.1, C4.1, C5.1, C11.1, C12.1, C13.1, C16.1, IC1.18 (VOUT), L1.2, R4.1, TP5.1
unnamed: C24.1, IC2.23 (BOOT)
unnamed: IC2.17 (FB), R12.1, R14.2
unnamed: IC2.21 (MODE1), R9.1
unnamed: IC2.20 (MODE2), R10.2
unnamed: IC2.24 (PHASE), R13.1
unnamed: IC2.5 (SW), IC2.6 (SW), IC2.7 (SW), IC2.8 (SW), IC2.9 (SW), IC2.30 (SW), L2.1
unnamed: C25.2, C26.1, C27.1, C28.1, C29.1, C30.1, C31.1, C32.1, IC2.18 (VOUT), L2.2, R14.1, TP9.1
unnamed: C40.1, IC3.23 (BOOT)
unnamed: IC3.17 (FB), R19.1, R21.2
unnamed: IC3.21 (MODE1), R16.1
unnamed: IC3.20 (MODE2), R17.2
unnamed: IC3.24 (PHASE), R20.1
unnamed: IC3.5 (SW), IC3.6 (SW), IC3.7 (SW), IC3.8 (SW), IC3.9 (SW), IC3.30 (SW), L3.1
unnamed: C41.2, C42.1, C43.1, C44.1, C45.1, C46.1, C47.1, C48.1, IC3.18 (VOUT), L3.2, R21.1, TP14.1
unnamed: C56.1, IC4.23 (BOOT)
unnamed: IC4.17 (FB), R26.1, R28.2
unnamed: IC4.21 (MODE1), R23.1
unnamed: IC4.20 (MODE2), R24.2
unnamed: IC4.24 (PHASE), R27.1
unnamed: IC4.5 (SW), IC4.6 (SW), IC4.7 (SW), IC4.8 (SW), IC4.9 (SW), IC4.30 (SW), L4.1
unnamed: C57.2, C58.1, C59.1, C60.1, C61.1, C62.1, C63.1, C64.1, IC4.18 (VOUT), L4.2, R28.1, TP19.1
unnamed: C72.1, IC5.23 (BOOT)
unnamed: IC5.17 (FB), R33.1, R35.2
unnamed: IC5.21 (MODE1), R30.1
unnamed: IC5.20 (MODE2), R31.2
unnamed: IC5.24 (PHASE), R34.1
unnamed: IC5.5 (SW), IC5.6 (SW), IC5.7 (SW), IC5.8 (SW), IC5.9 (SW), IC5.30 (SW), L5.1
unnamed: C73.2, C74.1, C75.1, C76.1, C77.1, C78.1, C79.1, C80.1, IC5.18 (VOUT), L5.2, R35.1, TP24.1
unnamed: SW1.2, U1.1 (IN)
unnamed: L6.2, U2.2 (SW)

Notes on the sheet:
1V5
1V375
Button
1V8
2V65
3V3

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
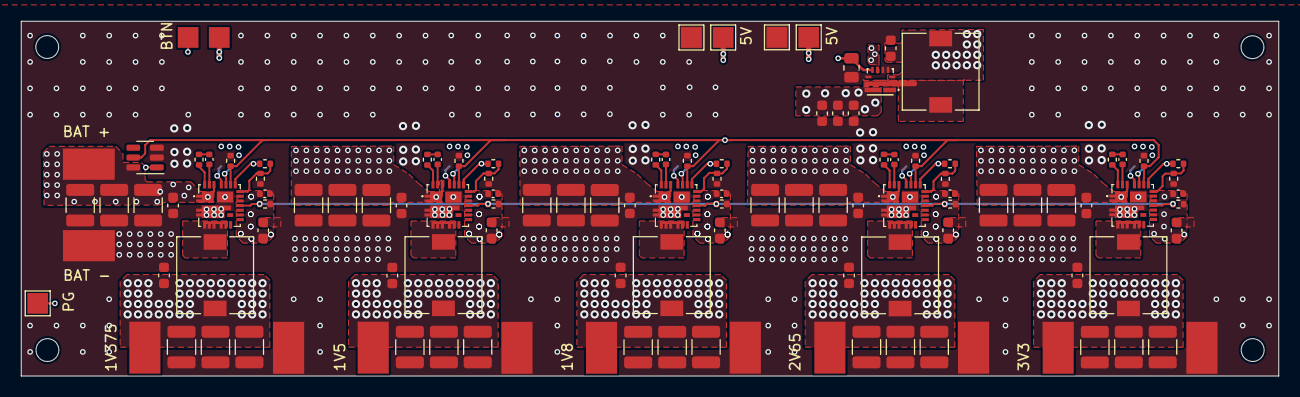
[picture p10: board Xbox-PMS.kicad_pcb from above]

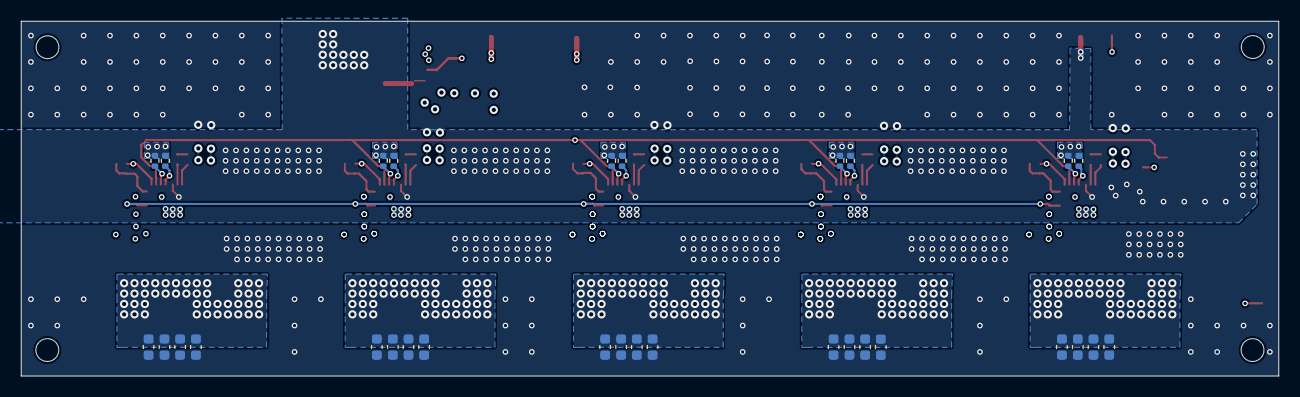
[picture p11: board Xbox-PMS.kicad_pcb from below]

Board: 13 copper layers, 121.2 x 34.2 mm, 150 parts (30 on the bottom side), 47 nets.

Other parts of the board:
 : MountingHole_2.2mm_M2
 #2,  #3,  #4: MountingHole_2.2mm_M2
TP18#2, TP18#3: TestPoint; TestPoint_Pad_2.0x2.0mm
