Redherring32/Xbox-Portable/FlexPCBs/IDE-Flex/IDEFlex.kicad_pcb

## KiCad design FlexPCBs/IDE-Flex/IDEFlex.kicad_pcb (2025-05-27)

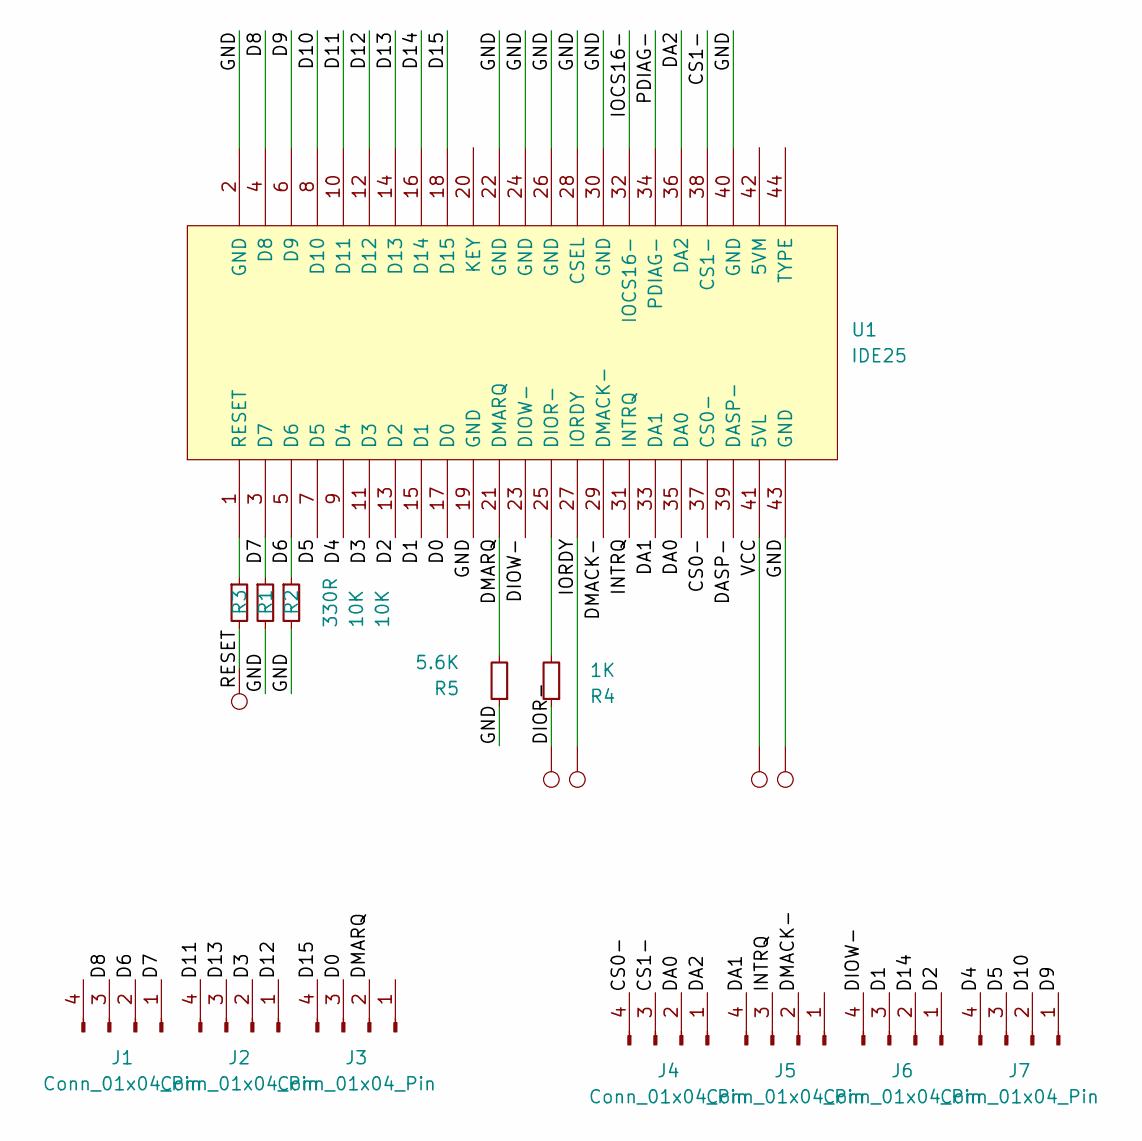
[picture p12: schematic IDEFlex.kicad_sch]

Parts:
J1, J2, J3, J4, J5, J6, J7: Conn_01x04_Pin; EdgePad
R1, R2: 10K; R_0402_1005Metric
R3: 330R; R_0402_1005Metric
R4: 1K; R_0402_1005Metric
R5: 5.6K; R_0402_1005Metric
TP1, TP2, TP3, TP4, TP5: TestPoint; TestPoint_Pad_D1.0mm
U1: IDE25; IDE

Connections:
/CS0-: J4.4, U1.37 (CS0-)
/CS1-: J4.3, U1.38 (CS1-)
/D0: J3.3, U1.17 (D0)
/D1: J6.3, U1.15 (D1)
/D2: J6.1, U1.13 (D2)
/D3: J2.2, U1.11 (D3)
/D4: J7.4, U1.9 (D4)
/D5: J7.3, U1.7 (D5)
/D6: J1.2, R2.1, U1.5 (D6)
/D7: J1.1, R1.1, U1.3 (D7)
/D8: J1.3, U1.4 (D8)
/D9: J7.1, U1.6 (D9)
/D10: J7.2, U1.8 (D10)
/D11: J2.4, U1.10 (D11)
/D12: J2.1, U1.12 (D12)
/D13: J2.3, U1.14 (D13)
/D14: J6.2, U1.16 (D14)
/D15: J3.4, U1.18 (D15)
/DA0: J4.2, U1.35 (DA0)
/DA1: J5.4, U1.33 (DA1)
/DA2: J4.1, U1.36 (DA2)
/DASP-: U1.39 (DASP-)
/DIOR-: R4.1, TP5.1
/DIOW-: J6.4, U1.23 (DIOW-)
/DMACK-: J5.2, U1.29 (DMACK-)
/DMARQ: J3.2, R5.2, U1.21 (DMARQ)
/GND: R1.2, R2.2, R5.1, TP4.1, U1.2 (GND), U1.19 (GND), U1.22 (GND), U1.24 (GND), U1.26 (GND), U1.28 (CSEL), U1.30 (GND), U1.40 (GND), U1.43 (GND)
/INTRQ: J5.3, U1.31 (INTRQ)
/IOCS16-: U1.32 (IOCS16-)
/IORDY: TP2.1, U1.27 (IORDY)
/PDIAG-: U1.34 (PDIAG-)
/RESET: R3.2, TP1.1
/VCC: TP3.1, U1.41 (5VL)
unnamed: R4.2, U1.25 (DIOR-)
unnamed: R3.1, U1.1 (RESET)

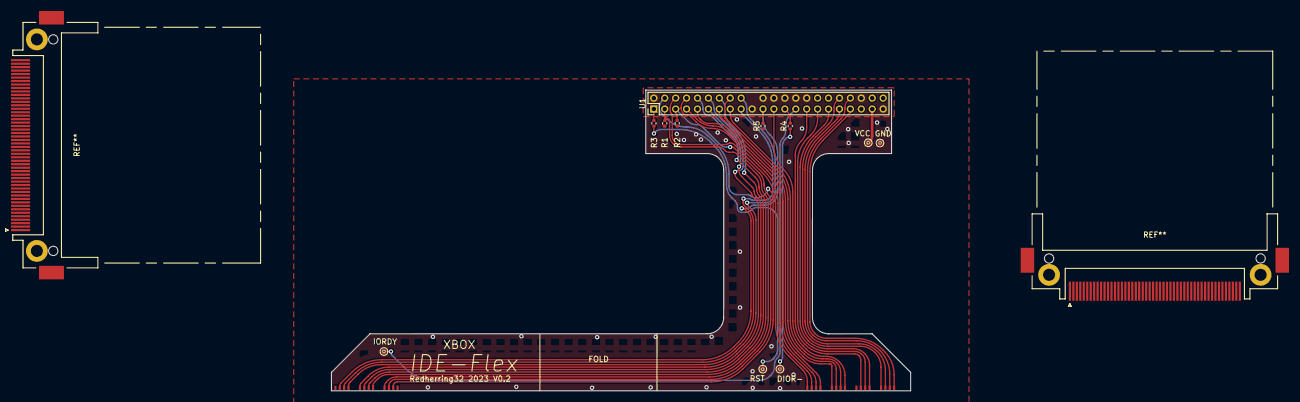
[picture p13: board IDEFlex.kicad_pcb from above]

Board: 11 copper layers, 106.1 x 55.1 mm, 18 parts (0 on the bottom side), 32 nets.
