Redherring32/Xbox-Portable/(commit log)

2024-06-10 Add PSU files
    [Xbox-PMS.kicad_pcb, Xbox-PMS.kicad_sch]
2024-06-10 Add temporary BOM.csv
    [BOM.csv]
2024-06-10 Add files for flex PCBs and controller PCBs
    [HDMI-FFC.kicad_pcb, HDMI-FFC.kicad_sch, IDEFlex.kicad_pcb, IDEFlex.kicad_sch, LPC-Flex.kicad_sch, S Controller.kicad_pcb, S Controller.kicad_sch, USB-Termination.kicad_pcb]
